parthbhalani2511/Embedded-Project/MINI ELEVATOR PROJECT WITH ARDUINO VIA BLUTOOTH MOBILE APP.pdf

# Universitá di Roma

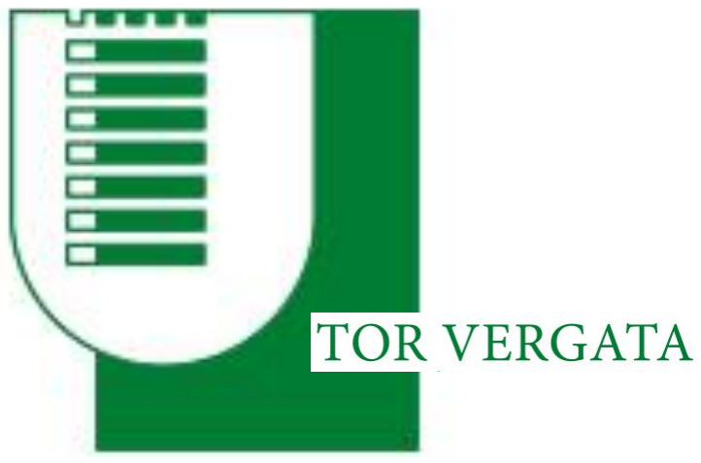
[picture p1: figure]

# Master of Science in Mechatronics Engineering & Department of Electronic Engineering (2023-2024)

# Project Name: Electronic IOT and Embedded Systems (EIES) Mini-Elevator Project

## Submitted by: Earnest Ofonaike Parth Bhalani Artem Myshliaev

## Submitted To:

Professor Giancarlo Orengo.

ii Content

i Cover page | - | - | - | - | - | - | - | - | - | - | 1
ii Content | - | - | - | - | - | - | - | - | - | - | - | 2
iii Forward | - | - | - | - | - | - | - | - | - | - | - | 3
1.0 Introduction | - | - | - | - | - | - | - | - | - | - | 3
1.1 Scope of Work - | - | - | - | - | - | - | - | - | - | 3
2.0 Features and Design Realization - - | - | - | - | - | - | - | 4
2.1. The features | - | - | - | - | - | - | - | - | - | 4
2.2 Mechanical Components - | - | - | - | - | - | - | 4
2.3 Electrical Components | - | - | - | - | - | - | - | 5
2.4 Electronic/Digital Components | - | - | - | - | - | - | 7
3.0 Design Realization | - | - | - | - | - | - | - | - | - | 7
3.1 The State | - | - | - | - | - | - | - | - | - | 7
3.2 Dynamics and Control | - | - | - | - | - | - | - | 8
3.3 Ascent - | - | - | - | - | - | - | - | - | - | 8
3.4 Descent - | - | - | - | - | - | - | - | - | - | 10
4.0 Algorithm and Programming - | - | - | - | - | - | - | - | 11
4.1 Arduino Sketch- | - | - | - | - | - | - | - | - | 13
4.2. The Mobile App | - | - | - | - | - | - | - | - | 19
5.0 Results and Inferences | - | - | - | - | - | - | - | - | 21
5.1 Conclusions | - | - | - | - | - | - | - | - | - | - | 21
References - | - | - | - | - | - | - | - | - | - | - | 21
Annexures | - | - | - | - | - | - | - | - | - | - | - | 22
Annex i: Datasheet 30V DC Motor | - | - | - | - | - | - | - | 22
Annex ii: Elevator Pulley Diagram | - | - | - | - | - | - | - | 26

iii. Forward

‘Any mechatronic student who cannot control a simple elevator system has got a problem on his hands’, Professor Riccardo Marino

The project became necessary when the statement was made during the course work of the control of mechanical system 2022/23. Therein the class, It resulted in assignment being given to student to model and simulate the elevator system.

The assignment became a challenge for modeling of this system. Base on the control analysis the system is of relative degree 2 and remain unstable such that there is a need to stabilize the plant, bring all the error to zero and bring the input to a constant value which is equivalent to the is disturbances (dead weight and friction) experienced.

When these problems were, to an extent, resolved theoretically, the doubt still exists that this simulation would not work as predicted with a physical model since there could be unforeseen variables. A group is students agreed to perform gap analysis by testing with physical model in the laboratory which necessitated initiation of this project – Mini Elevator Project.

### 1.0. Introduction

This project is the design and fabrication of a mini elevator system for the partial fulfilment of the course Electronic IOT and Embedded Systems (EIES). The word ‘Mini’ implies that the elevator system would be scaled to a portable size such that it can easily be moved into the electronic laboratory for all necessary test and evaluations, though scaled down dimensionally, it would beyond expectation, effectively give all the functionalities like that of a standards elevator.

Consequently, there a need to fabricate the mechanical parts which includes the carriage, the frame, and the pulley. Then install the Direct current (DC) motor, pullies, and the corresponding brackets. The softwarisation is implemented by the use of a microprocessor (Arduino Uno) and in addition to some other sensors to enable the required feedback and disturbance rejection.

The aim in brevity is to build the plant, implement control through micro-processor and smart sensors and then compare theoretical results with that of the physical results.

### 1.1. The scope of Work

- Features of the Elevator
- Dynamics and Control
- Design Realization
- Results and Inferences

### 2.0. Features and Design Realization

### 2.1. The features

The features of the sign can be categorized into three (3) parts which includes,
Mechanical, Electronics analogue and Electronics digital systems. Each of these subsystems have components that obeys the physical laws of the designated to it performance properties. Below is a brief description of each category of feature and expected functionality.

### 2.2. Mechanical Components

The system dimension is bound in space by 3D dimension box of about [200, 300, 1300] millimeters. Containing a carriage restricted to move in all other direction but only in the vertical z-direction. The carriage is to be suspended by a cord able to bear the load while in motion or at its stationary state. The cord is connected to a speed reducer pulley driven by the DC motor also to be mounted at the top of the frame. The DC motor functions through a speed reducer pulley system and tout to avoid slip and backlash. There are also Idler pullies to ensure that the system runs smoothly.

And the frame, the stanchion and the brackets are made of wood. The structure is well braced to ensure stability.

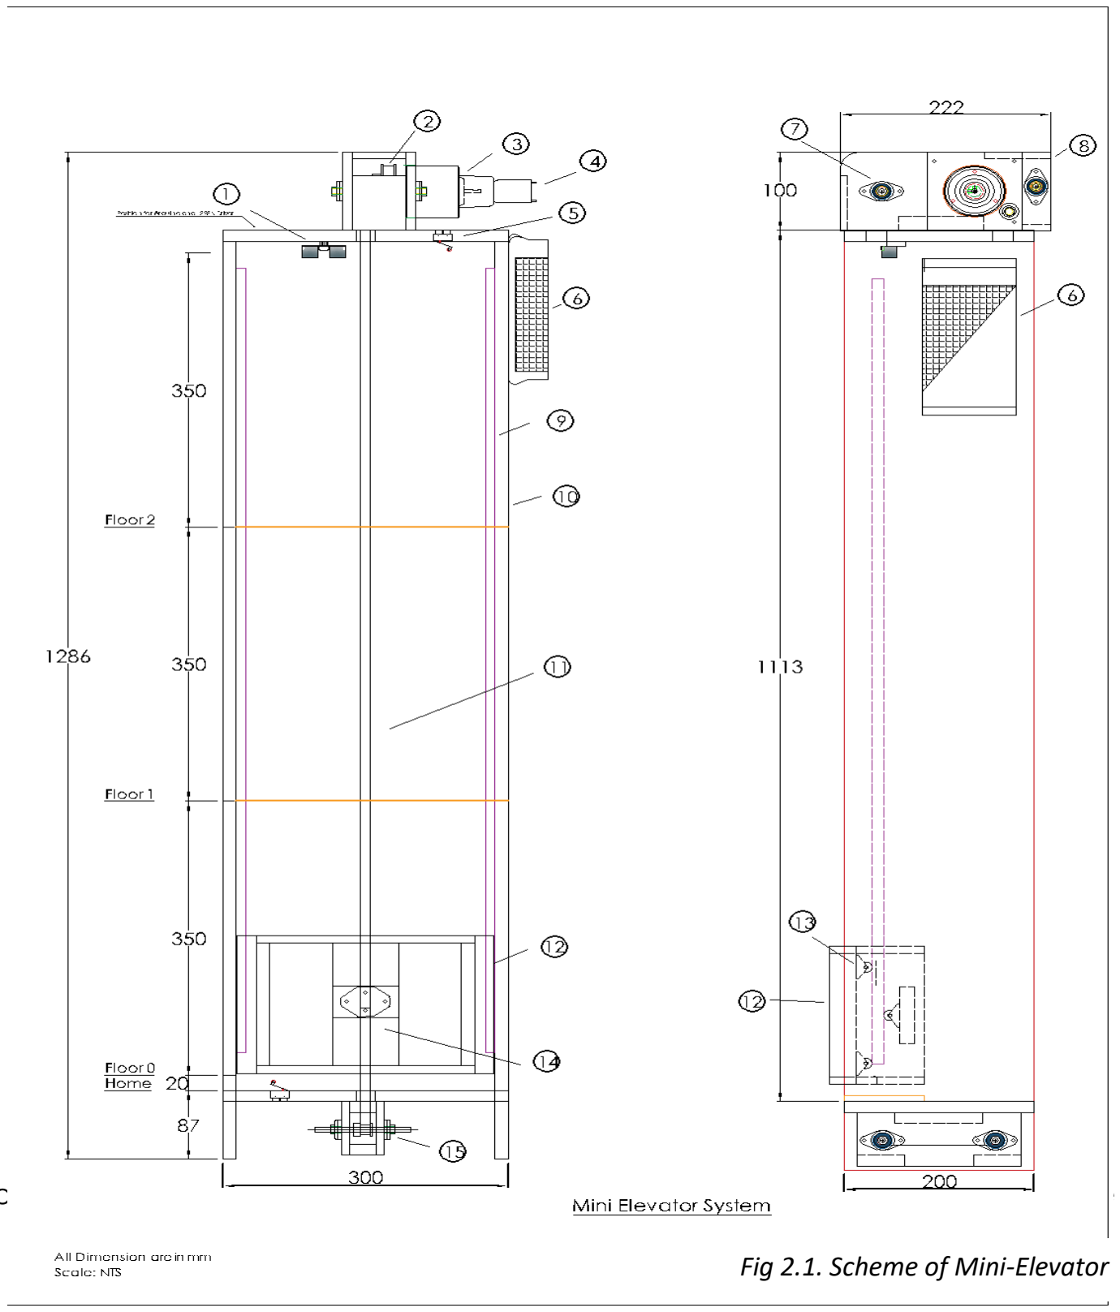
[picture p2: figure]
Fig 2.1. Scheme of Mini-Elevator

The major components that make up the elevator mechanical system is given in the table below.

Component of the Mini Elevator Part
No.
| Part Name | Description

### 1 HC SR04 Ultrasonic

| Sensor | This is used to measure the distance covered by the system
2 | Top Pulley System | This contains the sets of pinions and Idlers that pulls the belt and drive the carriage
3 | 30V DC motor | The is the system prime mover connect to 19mm pinion
4 | Tachometer | A dynamo connects to the spin of the electric motor. Its output voltage magnitude can be interpreted as the speed of the motor
5 | Limit Switches | Halts the movement of the carriage when it gets to permissible limits during movement

### 6 AC/DC Converter

| 240/24V | Supplied Power to the motor through the L298N Motor Driver
7 | Pillow Bearing | Host the pin and hub of the idlers and pinions
8 | Wooden bracket | Housing for the Pulley system and belts
9 | Guide Rail | Guide the movement of the carriage along the z - direction
10 | Stanchion | Body of the Elevators System. It is basically made of wood

### 11 Timing Belt _1

| | Drives the carriage and driven by 12mm diameter idlers. Timing Belt _2 drives the speed reducer system from the electric motor to the first Idler pulley.
12 | Carriage | This is pulled by the belt and has the capability to carry loads
13 | Roller For Carriage | Rolling wheels arranged to reduce friction between the carriage and the guide rail
14 | Belt anchor & Lock | Anchors and locks the belt the belt to the carriage to enable the pulling
15 | Base Pulley System | This contains the sets of Idlers that steadies the belt at the base as the carriage is driven

### 2.3. Electrical Component

Under the electrical systems, there is a 30V DC rated electric motor and is powered by 24V DC supply from an AC/DC converter. We use the 24V DC power supply because the motor can operate between 10 to 30V and we do not require more that 12V power supply for all our operations. The elevator system does not operate at high speed, but at a low bandwidth such that gentle accelerator and deceleration is required for the comfort of the users.

The mechanical time constant of the motor is about 20 microseconds and we require far less than 200 microseconds. We do not expect any signal attenuation. (Datasheet attached in the annex 1 for ready reference)

The electric motor is fitted with a mini generator to serve as a tachometer which interprets the speed of the motor. The out voltage is measurable, through analogue input pin of the Arduino board.

Power is also supplied to the microprocessor - Arduino Uno by a dedicated 9-volt AC/DC converter and the latter in turn supplies the 5v to smart Ultrasonic distance sensor (HC SR04) while it is connected to the Arduino power output through a breadboard. The Arduino drives the motor by enabling the L298N DC motor Driver.

Table 2.1. Component List and Description of Mini-Elevator Scheme

The Diagram below holds more information about the electrical connections.

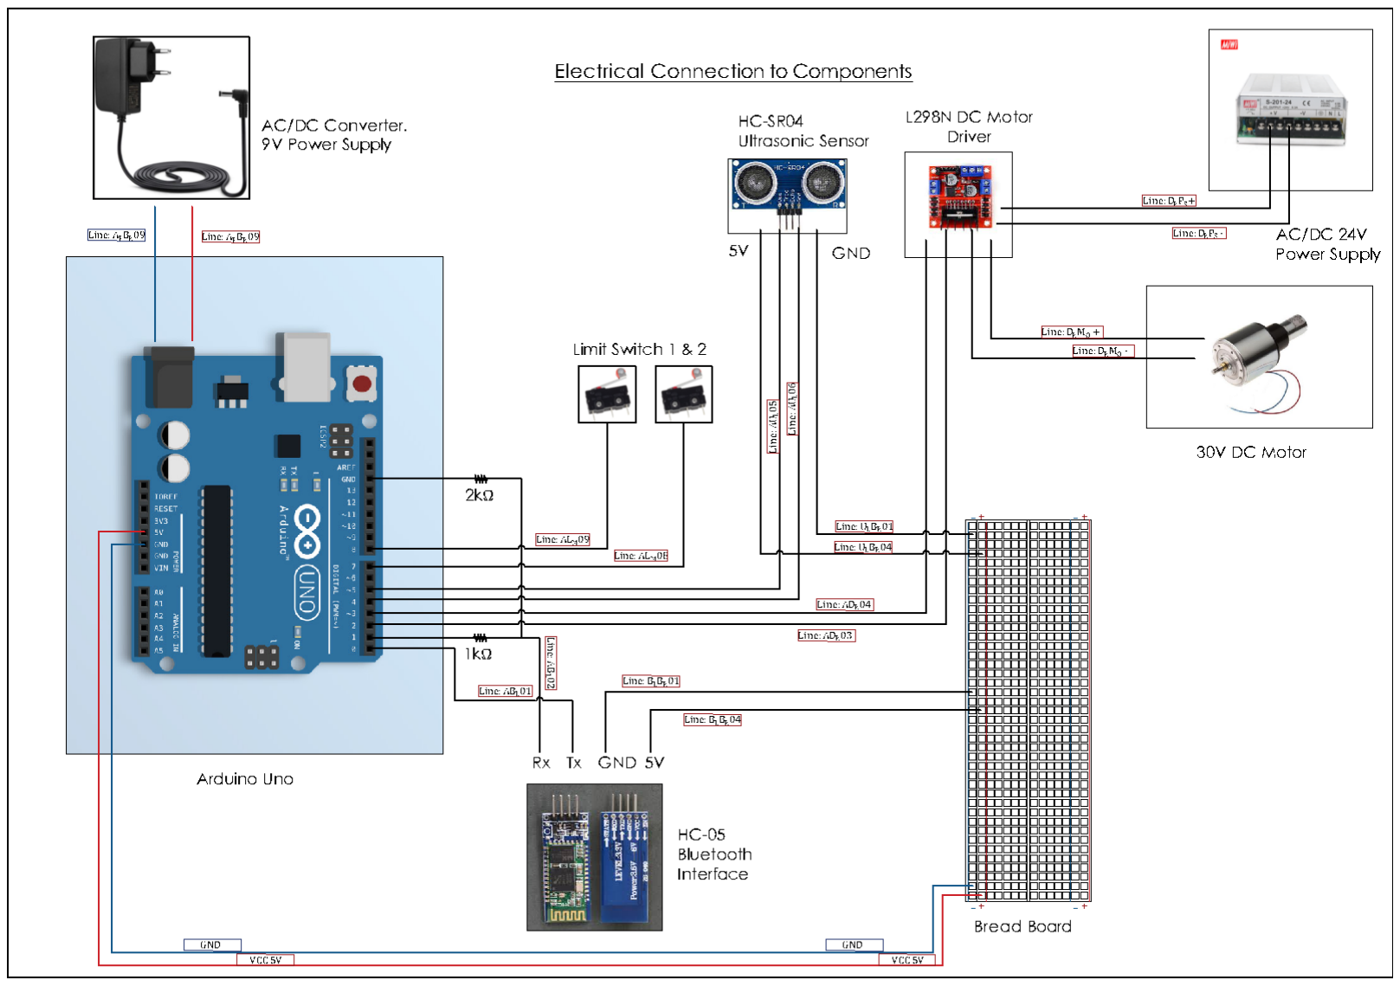
[picture p3: figure]

SR
NO.
LINE CODES | DESCRPITIONS
1 | ABL01 | Line from Arduino (0) to RXD Bluetooth HC-05 (5V)
2 | ABL02 | Line from Arduino (1) to TXD Bluetooth HC-05 (3.3V)
3 | BLBR01 | Line from Bluetooth HC-05 (2) GND to GND Breadboard (0V)
4 | BLBR04 | Line from Bluetooth HC-05 (1) VCC to VCC Breadboard (5V)
5 | ADR03 | Line from Arduino (2) to IN2 Motor Driver (L298N)
6 | ADR04 | Line from Arduino (3) to IN1 Motor Driver (L298N)
7 | DRMO | Line from Motor Driver L298N (1) to DC Motor
8 | DRMO | Line from Motor Driver L298N (2) to DC Motor
9 | DRPS V+ | Line from Motor Driver L298N to V+ AC/DC Power supply(24V)
10 | DRPS V- | Line from Motor Driver L298N to V- AC/DC Power supply(24V)
11 | ALM09 | Line from Arduino (8) to Limit switch 1
12 | ALM08 | Line from Arduino (7) to Limit switch 2
13 | AUL05 | Line from Arduino (4) to Echo (2) Ultrasonic sensor HC-SR04
14 | AUL06 | Line from Arduino (5) to Echo (3) Ultrasonic sensor HC-SR04
15 | ULBR01 | Line from Ultrasonic sensor HC-SR04 GND to GND Breadboard (0V)
16 | ULBR04 | Line from Ultrasonic sensor HC-SR04 VCC to VCC Breadboard (5V)
17 | APBR09 | Line from Arduino Analog pin (9) GND to GND Breadboard
18 | APBR10 | Line from Arduino Analog pin (10) GND to GND Breadboard

Fig 2.2. Electrical Circuits and Components

Table 2.2. Component List and Description for the Electrical Wiring

### 2.4. Electronics/ Digital Components

The microcontroller Arduino UNO is the central processing and controlling unit. It drives the system with L298N DC motor driver for speed and direction control. The feedback is the distance sensor wherein the HC-SR04 ultrasonic sensor is in place.

There is a HC - 05 Bluetooth asynchronous connection, from the central control to an android mobile device such that the control input is provided and monitored from the telephone.

### 3.0. Design Realization

### 3.1. The States

There are four states of operation of the system and in these states, there are specific operation which correspond to the operation of these states. The states are as follows: -

Off State: The system is powered down. The carriage is at the zero or ground floor, the off state can be initiated and the system powers off. If this state is imitated outside the ground floor, the carriage is moved to the ground floor before the shutdown.

On/Stationary state: This state is the stationary state. If the carriage is not moving, it is in this state. Once the system is switched on or get to desired floor, it goes to this state. In control this is the state wherein the control applies a holding torque, or the input becomes equivalent to the disturbances.

Ascent: The carriage travels in a direction against gravity in the positive z direction to a specified floor. The control is such that the system accelerates, travels at a given velocity and then decelerates gradually till it arrived at the desired floor. The control dynamics is divided into two based on the desired time for arrival to the different floors.

Descent: The descent is moving the same direction as gravity. In this case, the movement is not a free fall, controlled to move at the same pace like to the ascent.

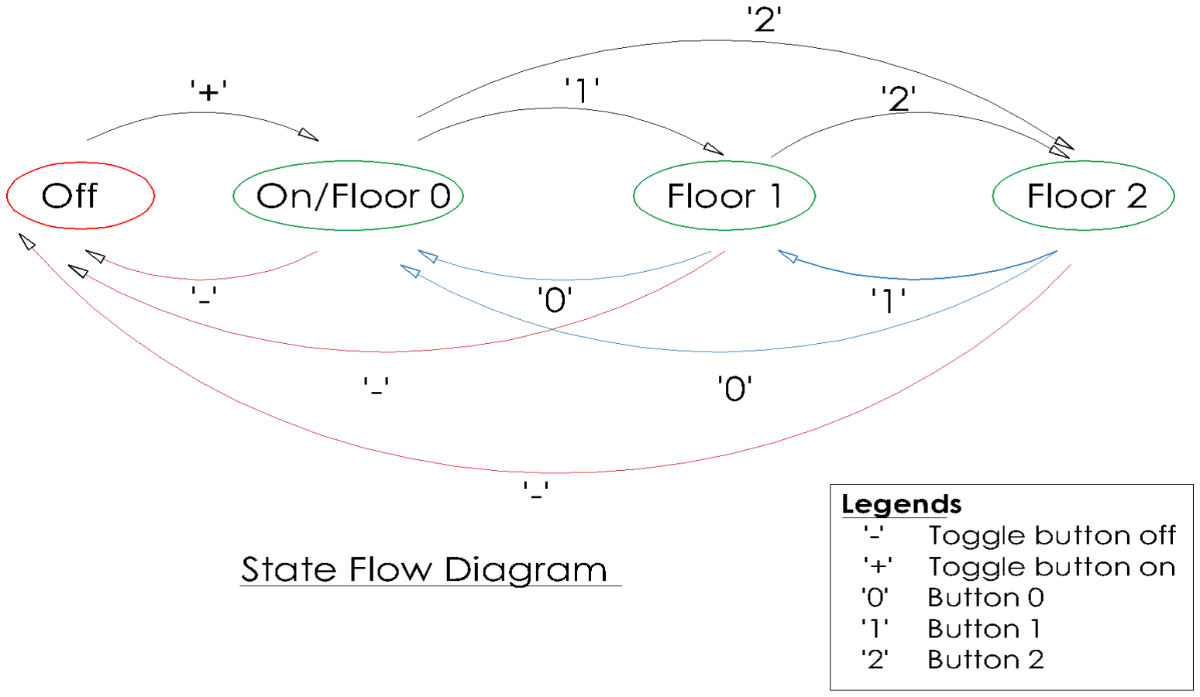
[picture p4: figure]

Fig 3.1. State flow schematic Diagram for Elevator Dynamics

### 3.2. Dynamics and control

The control was chosen such that the elevator gradually accelerates and decelerates to the comfort of the user. Considering the dynamic state, we have five (5) possible dynamics states which includes,

- Ascending single floor (+Cl * 1)
- Ascending double floor (+Cl * 2)
- Descending single floor (-Cl * 1)
- Descending double floor (-Cl * 2)
- Stationary position (balancing) – (Wt.)

Getting from to a subsequent from we design to take 6 second and two subsequent floor will take 8 seconds. And we allocate a 1 second max for estimation of disturbance (i.e. load). To enable the error to get to zero and the input to go to the value of the disturbance. We adopt the maximum velocity as 75mm/s.

### 3.3. Ascent

Ascending single floor (+Cl * 1) and ascending double floor (+Cl * 2)

Dynamics

y = k0 + k1t + k2t

2 + k3t

3
dy
dt = v = k1 + 2k2t + 3k3t

2

d

2y
dt² = a = 2k2 + 6k3t @ k1, k2, k3 = constants

Boundary conditions

Acceleration a = 2k2 + 6k3t
@t = 0, a = ao ; k2 =

ao
2
@t = ts

, a = 0 ; k3 =

−ao
6ts
velocity v = k1 + 2k2t + 3k3t

2

@t = 0, v = 0; k1 = 0
v = aot −

ao
2ts

t

2

y = k2t

2 + k3t

3

@t = ts

, v = vs

; v = aots −

aots
2

=

ao
2

ts

⇛ ao =

2vs
ts
− | − | (i)

v = aot −

ao
2ts

t

2 | − | − | (ii)

y = k2t

2 + k3t

3 =

| ao
| 2

t

2 −

ao
6ts

t

3 | − | (iii)

Tℎen during deceleration ( k2 = 0; k1 = vs

) tf = final time

y = k0 + k1t + k2t

2 + k3t

3

v = k1 + 2k2t + 3k3t
v = vs −

ao
2tf

t

y = vs

t −

ao
6tf

t

3

@t = tf, v = 0; ao =

2vs
tf
v = vs −

ao
2tf

t

2 − | − | (iv)

y = vst −

ao
6tf

t

3 | − | − | (v)

Motion profile

Given tℎat tℎe floor H = ys + vstx + yf ys = f (ts

) and yf = f (tf) calling equation (iii) and (v) H = (

ao
2

ts

2 −

ao 6ts | ts
3) + vstx + (vstf −
| | | ao 6tf
tf

3)

Total time t = ts + tx + tf = 6s also ts = tx = tf = 2s

H = (

ao
2

4 −

ao
12 ∗ 8) + 2vs + (2vs −

ao
12 ∗ 8)

= (2ao −

2ao
3

) + 2vs + (2vs −

2ao
3

)

calling equation (iv)

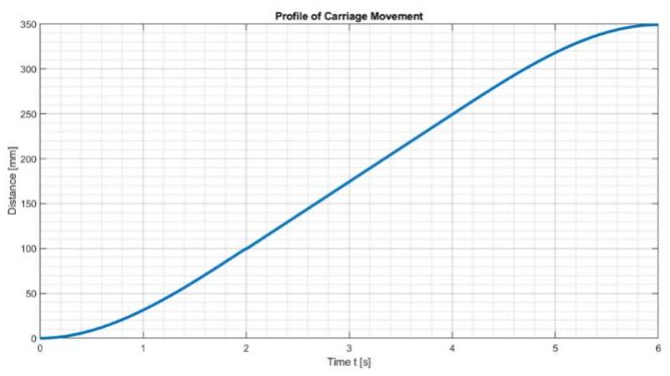
[picture p5: figure]

v = vs −

ao
2tf

t

2
; @t = tf, v = 0; ao =

2vs
tf

∴ vs =

aotf
2

=

2ao
2 | = ao
⇛ H = (2ao −

2ao
3

) + 2ao + (2ao −

| 2ao
| 3

)

H = (2ao −

2ao
3

) + 2ao + (2ao −

| 2ao
| 3

)

H =

14ao
3

@Heigℎt H = 350mm

ao =

3H
14 =

3 ∗ 350
14 | = 75mm/s
| 2

For computational convenience we give our distance in meters [m]

Fig 3.2. Distance – Time Profile in Millimetres

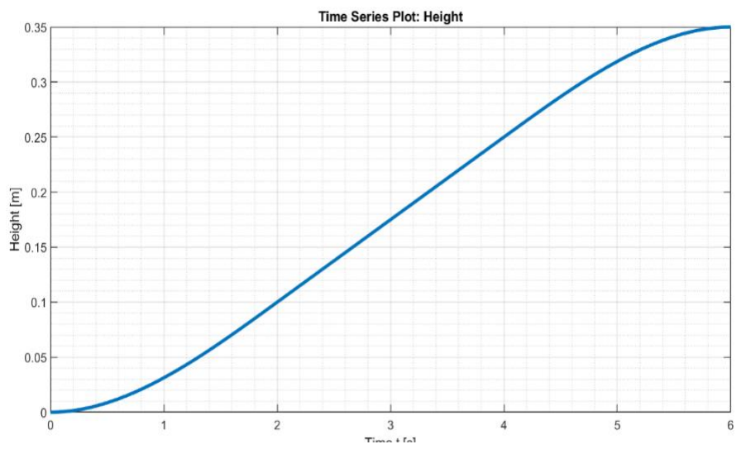
[picture p6: figure]

Fig 3.3. Distance – Time Profile in Metres

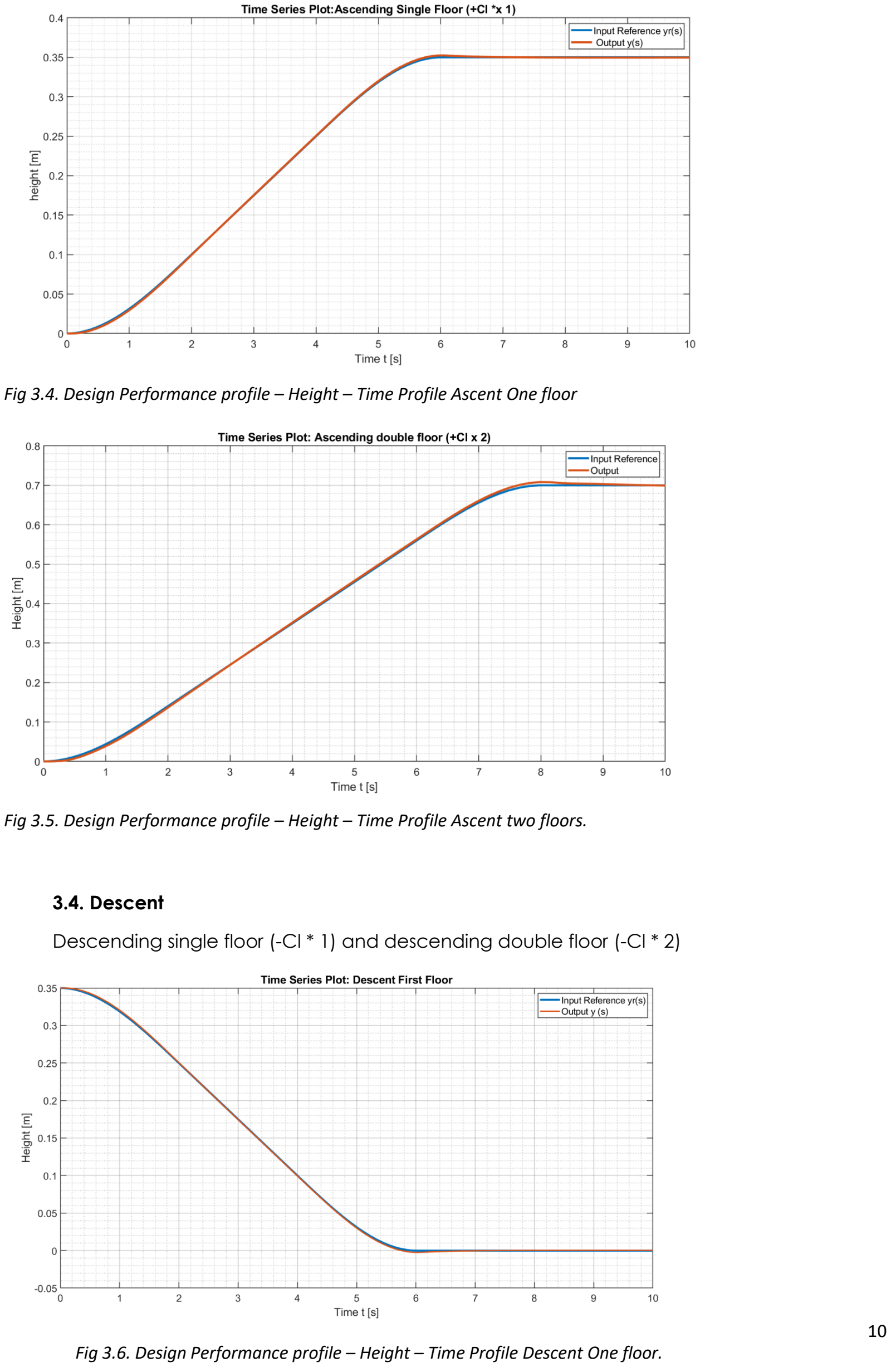
[picture p7: page 10]

### 3.4. Descent

Descending single floor (-Cl * 1) and descending double floor (-Cl * 2)

Fig 3.4. Design Performance profile – Height – Time Profile Ascent One floor

Fig 3.5. Design Performance profile – Height – Time Profile Ascent two floors.

Fig 3.6. Design Performance profile – Height – Time Profile Descent One floor.

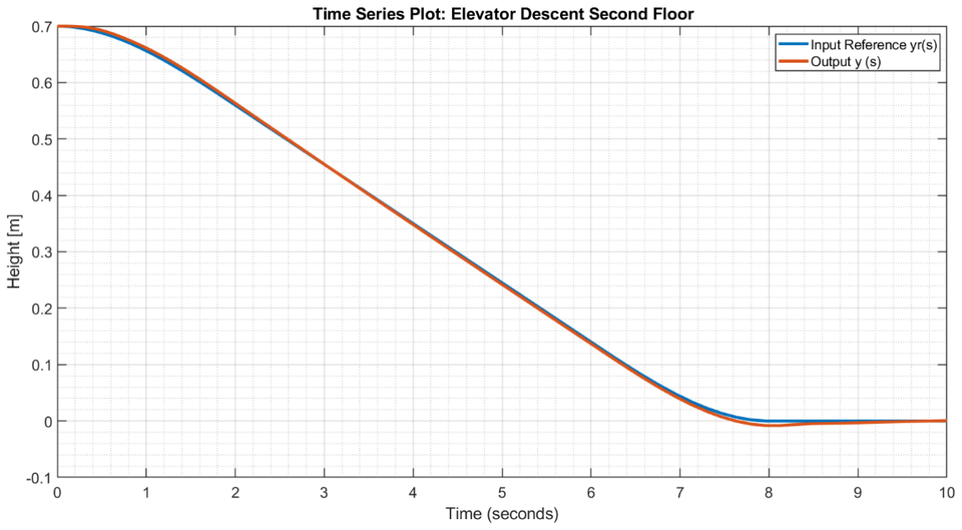
[picture p8: figure]

### 4.0. Algorithms and Programming

The main objective of the project - learn how to control a DC motor with Arduino sending commands through a Mobile App via Bluetooth. For solving this problem, the sketch for Arduino UNO board has been written and the mobile App has been developed in the MIT App Inventor.

- To simplify Speed Control of the motor, we decided to use the library “GyverMotor”.
- Pulse Width Modulation approach was used to provide different speed.
- To avoid ‘beeping’ at low speed, we used 10-bit PWM: the voltage input is mapped from 0 to 1023;
- There are 3 simple functions to define basic motion of the motor: goUp(), goDown() and stop(). They transform a duty cycle of PWM signal (in %) to control input.
- To handle Limit Switches, we used another library “ezButton”. The debounce time was added to prevent the button from being triggered again.
- Function ‘getDist()’ performs the distance measurement using Ultrasonic sensor. It sends the impulse to the carriage, then catches a reflected signal and calculates the time. Knowing the light speed, we can calculate the distance.
- The main loop consists of handling the commands from the app. The logic is quite simple. Since the movement down to Ground floor is the same in each case (stopping when the lower limit switch is pressed), we decided to isolate it into a separate function.
- If UP Limit Switch is touched the program stops.

Fig 3.7. Design Performance profile: Height – Time Profile Descent Two floors

12

13

### 4.1 The Arduino sketch:

#include <GyverMotor.h> | // import the library to control the motor

(https://github.com/GyverLibs/GyverMotor)
#include <ezButton.h> | // import the library to handle the limit switches presses

#define MOTOR_IN 2 | // define a digital pin №2 for the input motor signal

#define MOTOR_PWM 3 | // define a digital pin №3 for the input PWM motor signal

#define HC_ECHO 4 | // define a digital pin №4 for echo input signal from a Distance sensor HC-SR04

#define HC_TRIG 5 | // define a digital pin №5 for trigger output signal to a Distance sensor HC-SR04

#define LIM_SWITCH_DOWN 7 | // define a digital pin №7 for the input signal from the Bottom limit switch

#define LIM_SWITCH_UP 8 | // define a digital pin №8 for the input signal from the Upper limit switch

#define LED_mode 13 | // define a digital pin №13 for a built-in LED which indicates ON/OFF mode (ON

mode - LED ON, OFF mode - LED OFF)
#define LED_floor 12 | // define a digital pin №12 for a LED which indicates the floor when the mode is

ON (0 - LED ON, 1 - LED OFF, 2 - LED ON)

GMotor motor(DRIVER2WIRE, MOTOR_IN, MOTOR_PWM, HIGH); // create 'GMotor' object which is controlled by a driver using 2 signals (pins: MOTOR_IN, MOTOR_PWM)
ezButton limitSwitch_UP(LIM_SWITCH_UP); | // create 'ezButton' object for the Upper limit switch that attach to pin
LIM_SWITCH_UP;
ezButton limitSwitch_DOWN(LIM_SWITCH_DOWN); | // create 'ezButton' object for the Bottom limit switch that attach to pin
LIM_SWITCH_DOWN;
float const height0 = 82.0; | // distance from the sensor to the GROUND floor
float const height1 = 51.5; | // distance from the sensor to the FIRST floor
float const height2 = 18.0; | // distance from the sensor to the SECOND floor
int state = -1; | // elevator state: -1 (OFF mode - the elevator is anywhere), 0 (ON, Ground), 1
(ON, First), 2 (ON, Second)
char command = '-'; | // command from the app or a laptop: '-' (ON -> OFF), '+' (OFF -> ON, Ground), '0'
(1/2 -> 0), '1' (0/2 -> 1), '2' (0/1 -> 2)

14

float dist; | // distance to the elevator carriage that is calculated from the Distance sensor
measurements [function 'getDist()']
float err; | // distance error between the required floor and the current distance
bool flagON = false, flagOFF = false, flagRED = false; // flags that allow/forbid message output (to print the message only once)
uint32_t tmr_dist = 0; | // time variable for storing the starting point.

void setup() {
motor.setMode(AUTO); | // set the motor operating mode (AUTO = automatic direction determination, others:
FORWARD, BACKWARD, STOP)
motor.setResolution(10); | // set 10-bit PWM mode: -1023..1023 (increasing the frequency helps to avoid
"beeping" at low speed)
TCCR2B = 0b00000001; | // set the Timer 1 (pins D3 & D11) to the 10-bit resolution
TCCR2A = 0b00000001;
Serial.begin(9600); | // initialize the serial communication
Serial.println("Start of the program!");
pinMode(LED_mode, OUTPUT); | // set the LED_mode pin as output
pinMode(LED_floor, OUTPUT); | // set the LED_floor pin as output
pinMode(HC_TRIG, OUTPUT); | // set the HC_TRIG pin as output
pinMode(HC_ECHO, INPUT); | // set the HC_ECHO pin as input
limitSwitch_DOWN.setDebounceTime(50); | // set debounce time to 50 [ms] for each limit switch
limitSwitch_UP.setDebounceTime(50);
}

/* -----------------------------------------------------------------------
ALGORITHM:
Inititally the system is in OFF mode (state = -1), the carriage can be anywhere.
OFF -> ON (command '+'): the elevator goes to the Ground floor (state = 0), stops and waits for a new command;
ON -> OFF (command '-'): the elevator stops (state = -1);
command '1': 0 -> 1 (the elevator goes up and stops at the 1 floor), 2 -> 1 (the elevator goes down and stops at the 1 floor); command '2': 0/1 -> 2 (the elevator goes up and stops at the 2 floor);

15

command '0': 1/2 -> 0 (the elevator goes down and stops at the Ground floor);

To ensure precise positioning, the Feedback control was applied: the distance error drives to zero. The downward movement continues until the bottom limit switch is pressed [function 'goHome()']. RED BUTTON: to stop the system quickly, it is sufficient to press the Upper limit switch. --------------------------------------------------------------------------- */

void loop() {
//Continuous data update
limitSwitch_DOWN.loop(); | // continuously read the signals from the Limit switches
limitSwitch_UP.loop();
if (millis() - tmr_dist >= 100) { | // read the distance from the sensor HC-SR04 every 100 [ms]
tmr_dist = millis(); | // reset the starting point (function 'millis()' returns number of milliseconds
passed since the program started)
dist = getDist(); | // get the distance from the sensor
}

//Reading commands from the Serial port or the RED BUTTON
if (limitSwitch_UP.getState() == LOW) { | // RED BUTTON: if Upper limit switch is pressed, the system will switch to OFF
mode
command = '-'; | // this command will stop the motor
if (flagRED == false) { | // print (once!) that the Red Button was pressed
Serial.println("RED BUTTON!");
flagRED = true;
}
}
else if (Serial.available()) { | // read the command from the Serial port: Bluetooth (a Mobile app) or USB (a
laptop)
command = Serial.read();
}

//Command handling according to the elevator state
if (command == '-') { | // ON -> OFF
stop(); | // stop the motor

16

digitalWrite(LED_mode, LOW); | // turn off the LED to indicate that the elevator is NOT active
digitalWrite(LED_floor, LOW); | // turn off the LED which indicates the floor
state = -1; | // switch to OFF mode
if (flagOFF == false) { | // print (once!) that the Mode was changed
Serial.println("OFF mode");
flagOFF = true;
flagON = false; | // reset the flag to activate an ability to print messages about ON mode
}
}
else if (command == '+' && state == -1) { | // OFF -> ON
goHome(); | // go down to the Ground floor (state = 0, command = '0')
digitalWrite(LED_mode, HIGH); | // turn on the LED to indicate that the elevator is active
if (flagON == false) { | // print (once!) that the Mode was changed
Serial.println("ON mode");
flagON = true;
flagOFF = false; | // reset the flags to activate an ability to print messages about OFF mode
flagRED = false;
}
}
else if (command == '0' && (state == 1 || state == 2)) { | // 1 or 2 -> 0
goHome(); | // go down to the Ground floor (state = 0, command = '0')
}

else if (command == '1') {
if (state == 0) { | // 0 -> 1
err = dist - height1; | // calculate the distance error
Serial.println(err); | // print a curent value of the error
if (err > 0) {goUp(err);} | // go UP until the error is zero
else {
stop(); | // stop the motor
state = 1;
digitalWrite(LED_floor, LOW); | // turn off the LED to indicate that the elevator is on the 1-st floor

17

Serial.println("1-st floor"); | // print that the elevator has reached the 1-st floor
}
}
else if (state == 2) { | // 2 -> 1
err = height1 - dist; | // calculate the distance error
Serial.println(err); | // print a curent value of the error
if (err > 0) {goDown(err);} | // go DOWN until the error is zero
else {
stop(); | // stop the motor
state = 1;
digitalWrite(LED_floor, LOW); | // turn off the LED to indicate that the elevator is on the 1-st floor
Serial.println("1-st floor"); | // print that the elevator has reached the 1-st floor
}
}
}

else if (command == '2' && (state == 0 || state == 1)) { // 0 or 1 -> 2
err = dist - height2; | // calculate the distance error
Serial.println(err); | // print a curent value of the error
if (err > 0) {goUp(err);} | // go UP until the error is zero
else {
stop(); | // stop the motor
state = 2;
digitalWrite(LED_floor, HIGH); | // turn on the LED to indicate that the elevator is on the 2-nd floor
Serial.println("2-nd floor"); | // print that the elevator has reached the 2-nd floor
}
}
}

void goHome() {
if (limitSwitch_DOWN.getState() == HIGH) { | // while the elevator doesn't reach the Bottom limit switch
err = height0 - dist; | // calculate the distance error
Serial.println(err); | // print a curent value of the error
goDown(err); | // go DOWN until the error is zero

18

}
else {
stop(); | // stop the motor
state = 0;
command = '0';
digitalWrite(LED_floor, HIGH); | // turn on the LED to indicate that the elevator is on the GROUND floor
Serial.println("Ground floor"); | // print that the elevator has reached the GROUND floor
}
}
void goUp(float err) { | // function to force the elevator go UP (with decceleration at the end)
if (err > 10) {motor.setSpeed(u(9));}
else if (err > 5) {motor.setSpeed(u(8));} | // as the elevator approaches the desired floor, it reduces the speed
else {motor.setSpeed(u(7));}
}
void goDown(float err) { | // function to force the elevator go DOWN (with decceleration at the end)
if (err > 10) {motor.setSpeed(-u(8));}
else if (err > 5) {motor.setSpeed(-u(7));} | // as the elevator approaches the desired floor, it reduces the speed
else {motor.setSpeed(-u(6));}
}
void stop() { | // function to stop the motor
motor.setSpeed(0);
}
float u(int duty_cycle) { | // function to get a motor PWM signal (0..1023) by a duty cycle (in %)
return (duty_cycle/100) * 1024;
}
float getDist() { | // function to get the Distance from HC-SR04 ultrasonic sensor (returns the
distance to the Elevator carriage)
digitalWrite(HC_TRIG, HIGH); | // set trigger
delayMicroseconds(10); | // trigger impulse duration = 10 [mcs]

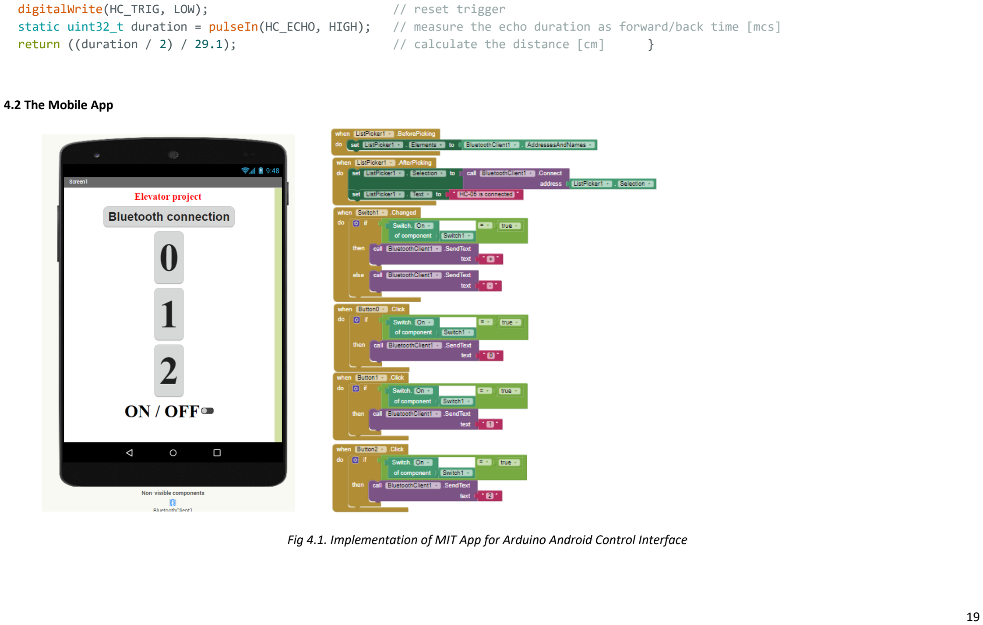
[picture p9: page 19]

19

digitalWrite(HC_TRIG, LOW); | // reset trigger
static uint32_t duration = pulseIn(HC_ECHO, HIGH); | // measure the echo duration as forward/back time [mcs]
return ((duration / 2) / 29.1); | // calculate the distance [cm] | }

### 4.2 The Mobile App

Fig 4.1. Implementation of MIT App for Arduino Android Control Interface

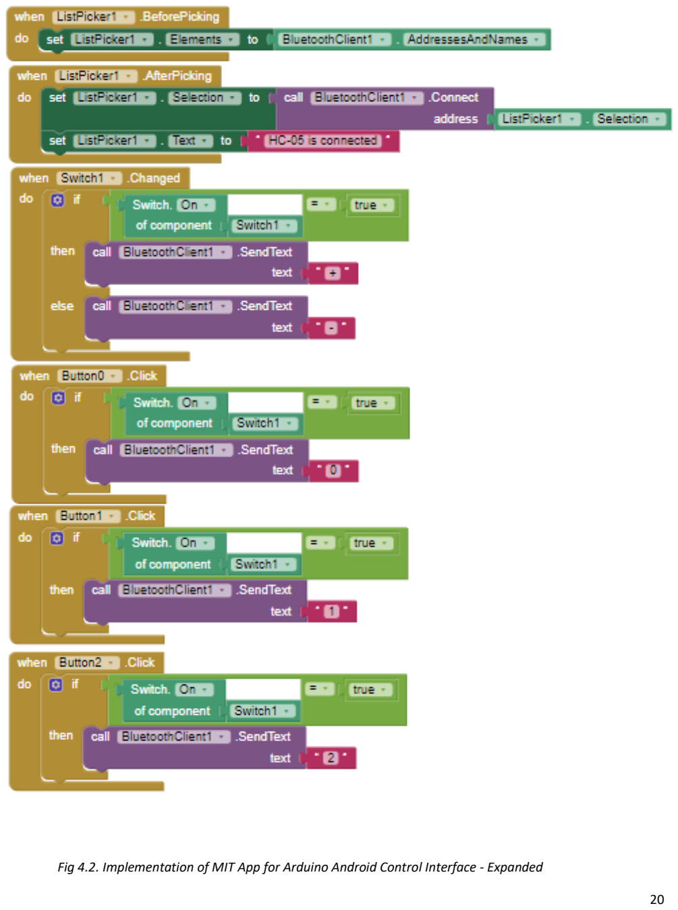
[picture p10: page 20]

Fig 4.2. Implementation of MIT App for Arduino Android Control Interface - Expanded

The Mobile App comprises of 5 blocks: a ListPicker, a Switch and 3 buttons. List Picker aids in in connecting the smartphone to the Arduino Bluetooth Module choosing it from the list.

Changing the state of the Switch leads to sending the symbol ‘+’ or ‘-‘to Arduino Board. The floor buttons work only when the elevator is in ON mode.

### 5.0. Results and inferences

The elevator system performed as anticipated. It’s acceleration and deceleration are gradual as per design and its carriages moves to the designated by inputting the reference floor on the android phone to the designated locations which represents the floor of interest.

We experience so system noise due to friction and some alignment error, but the system design with a feedback control system has an appreciable noise rejection capability. It simply brings the error signal to zero and also disturbances due to dead weight at the carriage and friction was also attenuated.

### 5.1. Conclusions

The possibility of system and sensor noise was witnessed and confirmed. The Arduino performed as predicted and to communicate wirelessly to remote device through a Bluetooth device.

The elevator, model can be recommended to be prototyped but with implementation of the fail-safe breaking system which we did achieved by using on a feedback design and hold torque from the DC electric motor.

The effect of friction and some parallax defects can be greatly reduced by fabricating components in a standard workshop as the elevator system was hand crafted just examine system noise rejection using feedback.

The elevator project has been completed successfully to the partial fulfilment of the course Internet of Things (IOT) and Embedded systems. The project reaffirms all that was theoretically instructed in the course work and performed as anticipated.

References

[1] Giancarlo Orengo. Lesson Notes “Prototyping Boards & Languages for IoT ”Tor Vergata Roma A.A 2022/2033.
[2] O’ Reilly and M. Margolis, “Arduino Cookbook” 2nd Edition; ISBN 978-1-449-31387-6, -December 2011
[3] RS PRO (St. No. 263 -6005)” Datasheet 30W servo Motor 24 – 30 V DC 14Ncm, 1600 rpm Motor,” December 1999.

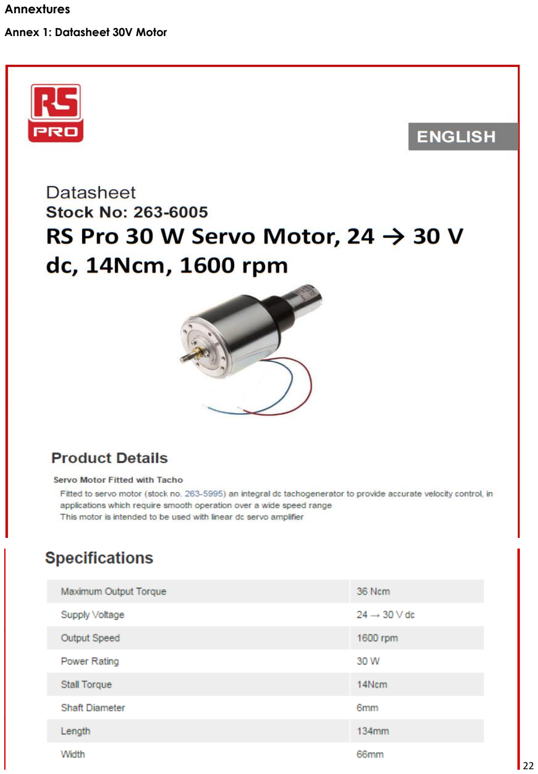
[picture p11: page 22]

Annextures

Annex 1: Datasheet 30V Motor

Annexes

Annex 1: Datasheet Electric Motor

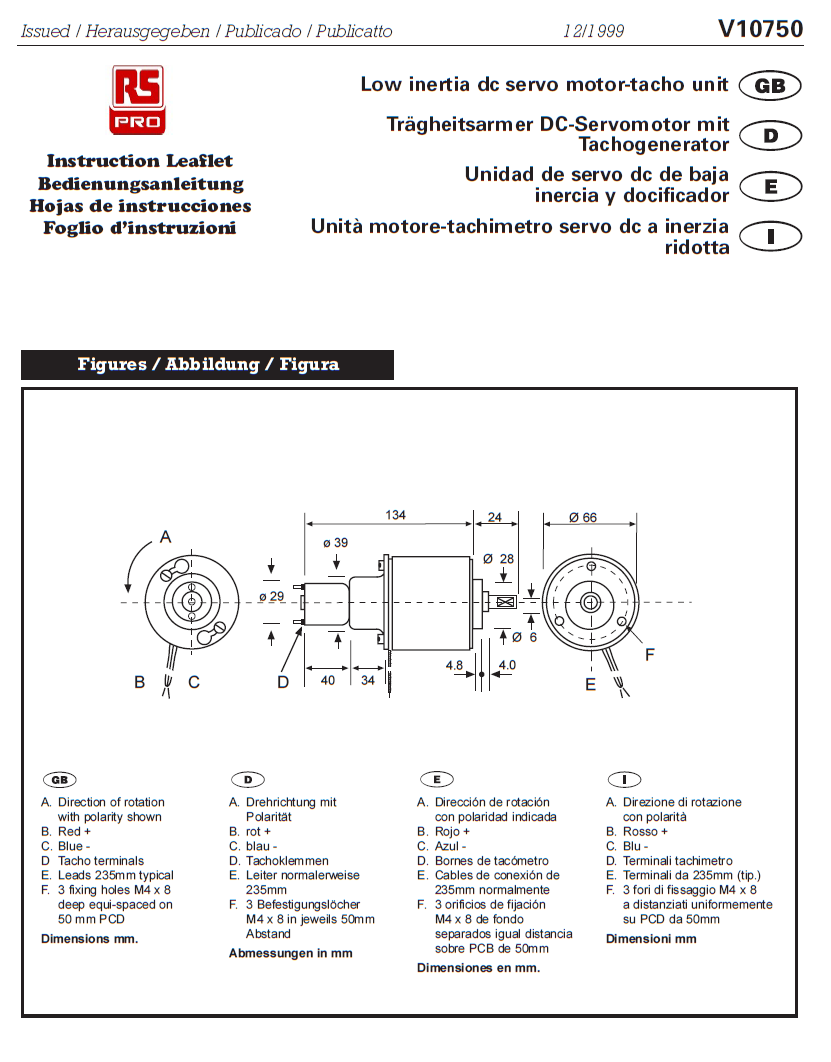
[picture p12: page 23]
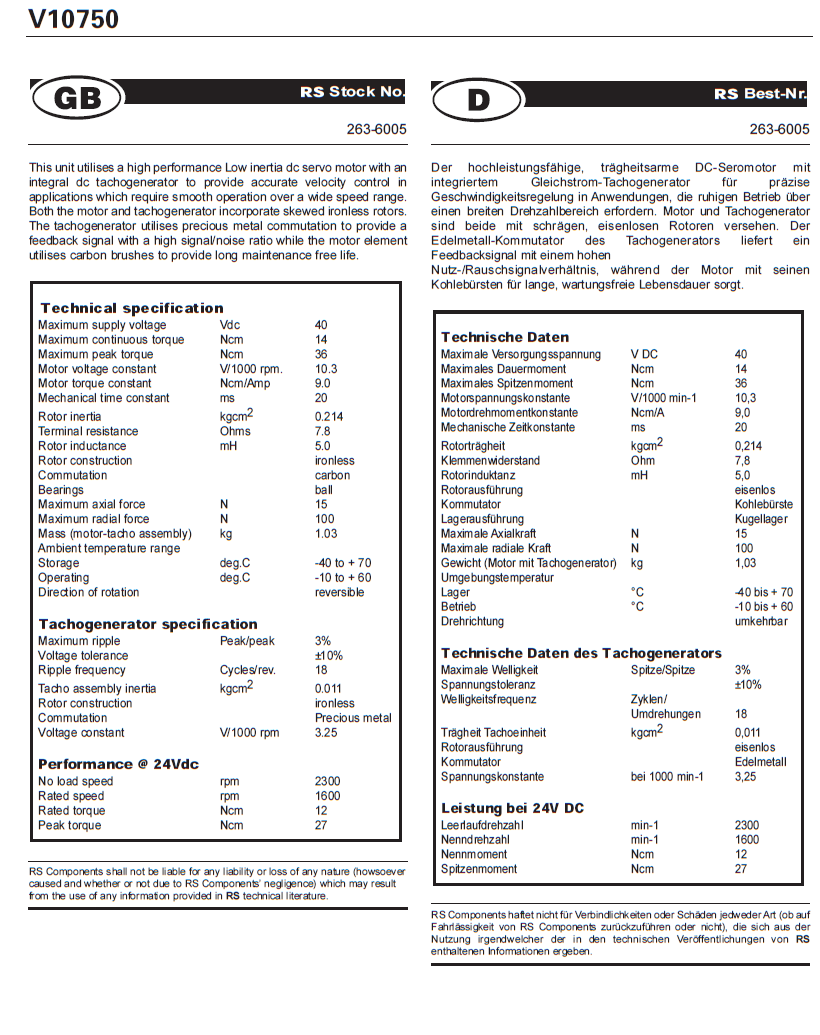
[picture p13: page 24]
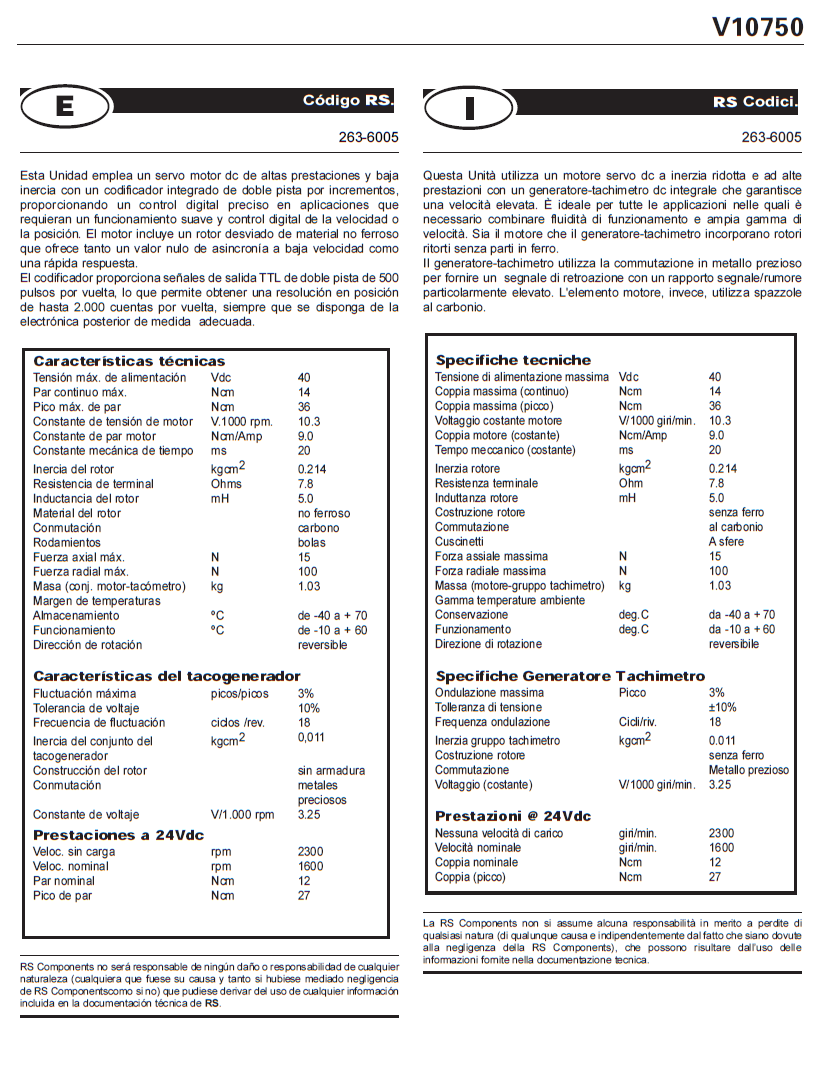
[picture p14: page 25]
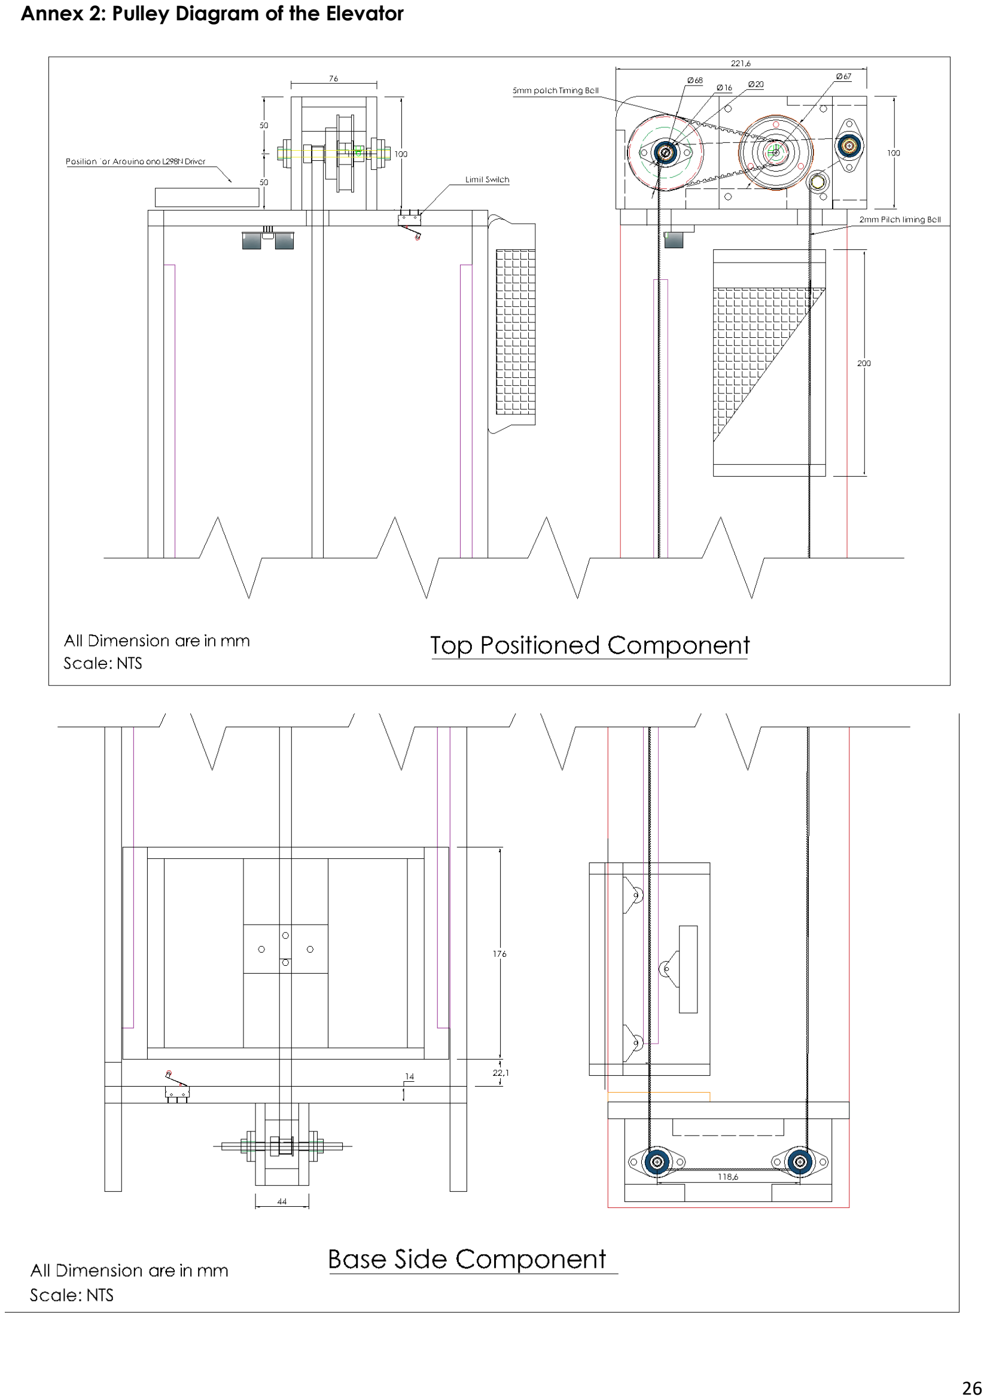
[picture p15: page 26]

Annex 2: Pulley Diagram of the Elevator

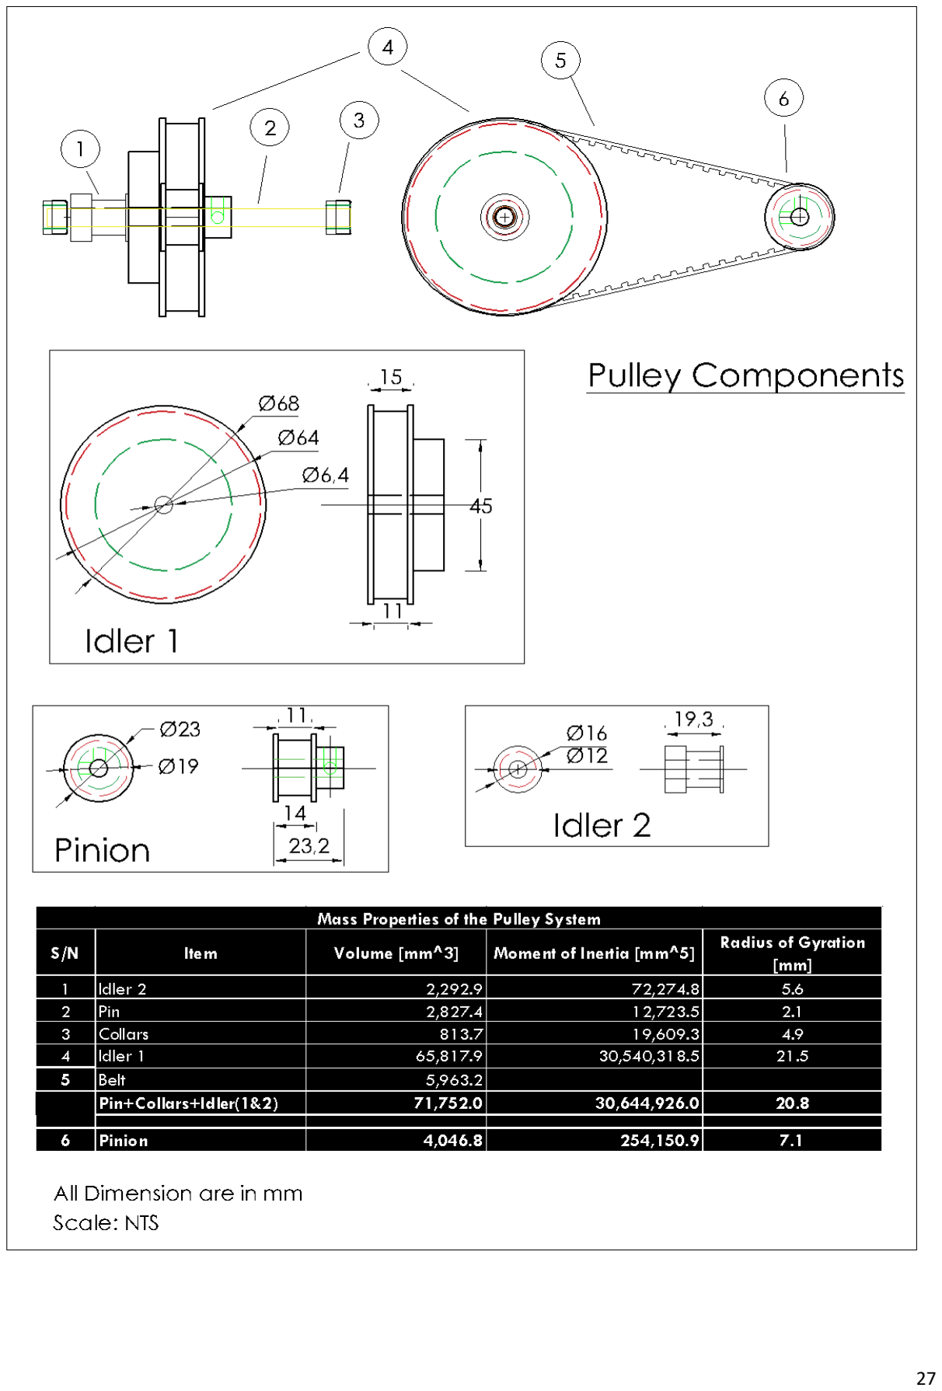
[picture p16: page 27]
