parthbhalani2511/Embedded-Project/Electrical Diagram.pdf

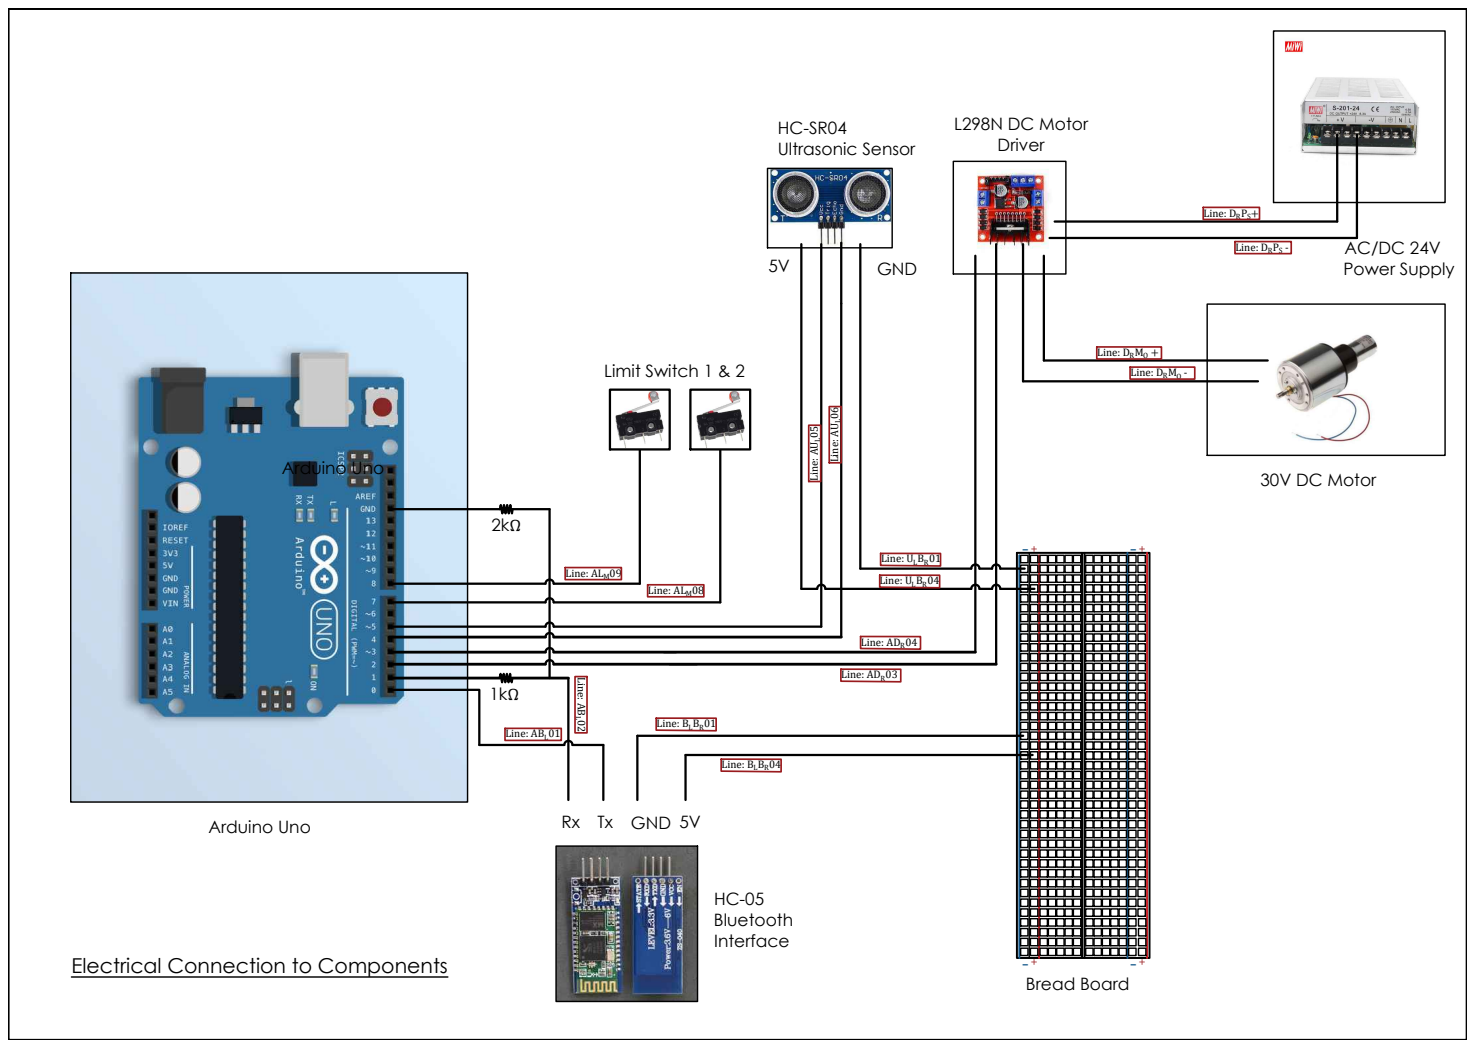
[picture p17: page 1]
AC/DC 24V Power Supply; Arduino Uno; Ultrasonic Sensor; 30V DC Motor; L298N DC Motor; Bread Board; Limit Switch 1 & 2; + - Arduino Uno; Line: ABL01; Line: ABL02; Line: BLBR01; Line: ALM09; Line: DRMO +; Line: BLBR04; Line: ADR03; Line: ADR04 Line: AUL06; Line: ALM08; Line: DRPS; - Line: DRMO -; Line: ULBR01; Line: ULBR04

Line: DRPS+ Line: AUL05

Rx Tx GND 5V

Electrical Connection to Components
